TTNApeldoorn/esp32-p1-watermeter-node/hardware/documentation/LILYGO-G511-01_1_-1500x1500.jpg

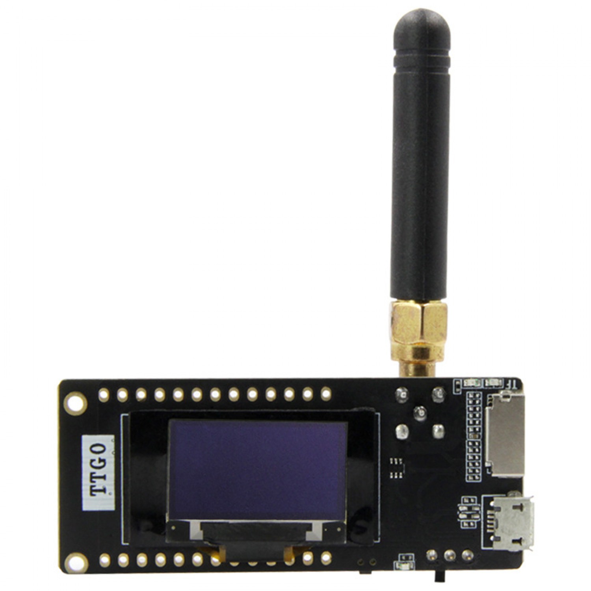
hardware/documentation/LILYGO-G511-01_1_-1500x1500.jpg
