TTNApeldoorn/esp32-p1-watermeter-node/hardware/documentation/LILYGO-G240-01_3_-1500x1500.jpg

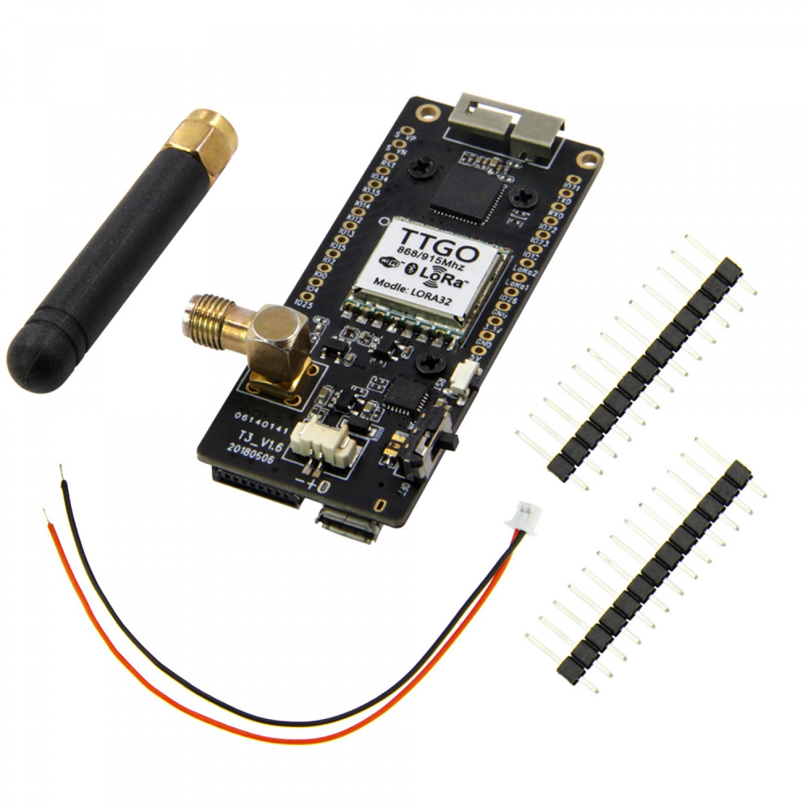
hardware/documentation/LILYGO-G240-01_3_-1500x1500.jpg
