TTNApeldoorn/esp32-p1-watermeter-node/hardware/documentation/bom.md

[Terminal Block voor Afneembare Schroefterminal - 90° - 3p - 3.81mm](
https://www.tinytronics.nl/nl/kabels-en-connectoren/connectoren/schroefterminals/terminal-block-voor-afneembare-schroefterminal-90-3p-3.81mm)
[Afneembare Schroefterminal - 3p - 3.81mm](https://www.tinytronics.nl/nl/kabels-en-connectoren/connectoren/schroefterminals/afneembare-schroefterminal-3p-3.81mm)

[LJ18A3-8-Z/BX - 5V Nabijheids sensor N/O NPN 8mm](https://opencircuit.nl/product/lj18a3-8-z-bx-5v-nabijheids-sensor-n-o-npn-8mm)
