TTNApeldoorn/esp32-p1-watermeter-node/hardware/documentation/2b7144094_lj18a3-8-z-bx-5v-nabijheids-sensor-n-o-npn-8mm_x.jpg

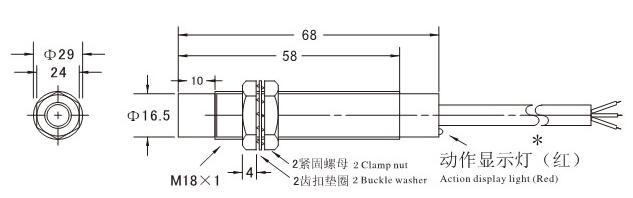
hardware/documentation/2b7144094_lj18a3-8-z-bx-5v-nabijheids-sensor-n-o-npn-8mm_x.jpg
