TTNApeldoorn/esp32-p1-watermeter-node/hardware/documentation/LILYGO-G240-01_4-1500x1500h.jpg

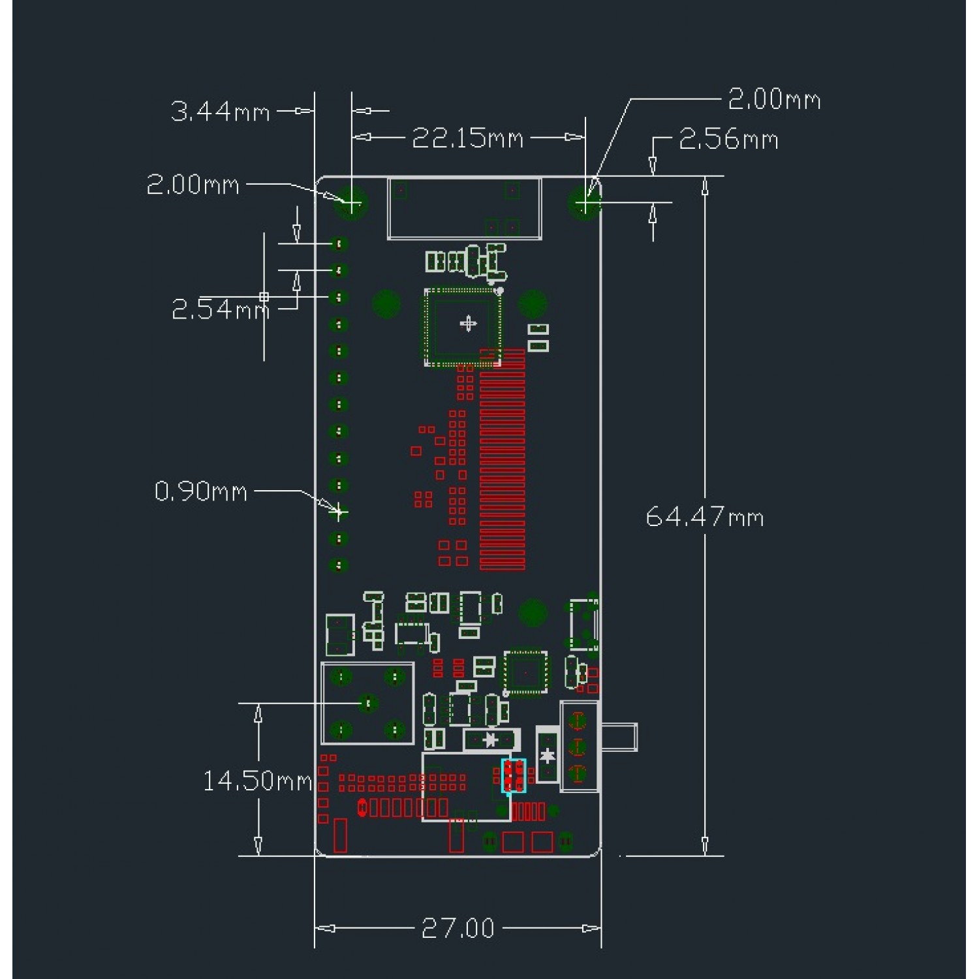
hardware/documentation/LILYGO-G240-01_4-1500x1500h.jpg
