TTNApeldoorn/esp32-p1-watermeter-node/hardware/documentation/removable-screw-terminal-3p-3.81mm-dimensions-600x600w.jpg

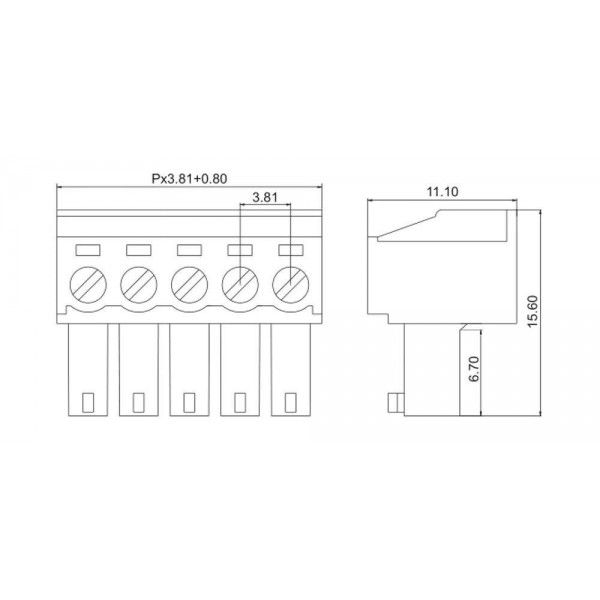
hardware/documentation/removable-screw-terminal-3p-3.81mm-dimensions-600x600w.jpg
