TTNApeldoorn/esp32-p1-watermeter-node/hardware/documentation/terminal-block-for-removable-screw-terminal-90-3p-3.81mm-dimensions-600x600w.jpg

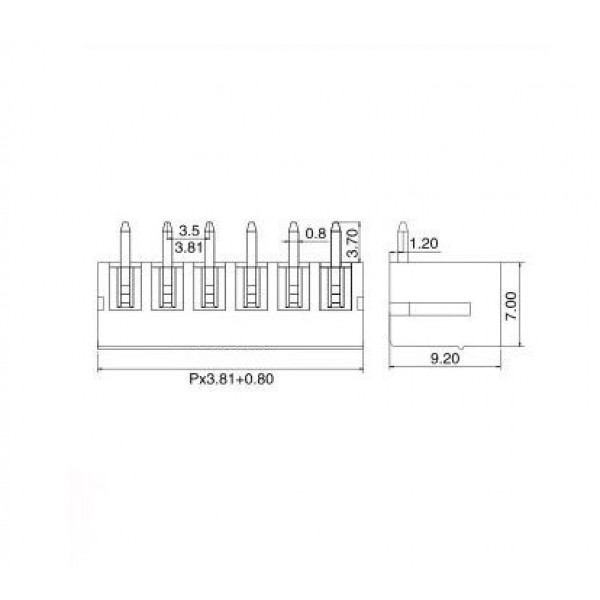
hardware/documentation/terminal-block-for-removable-screw-terminal-90-3p-3.81mm-dimensions-600x600w.jpg
