TTNApeldoorn/esp32-p1-watermeter-node/hardware/esp32-p1-water-node-board/esp32-p1-node-board/0_5_Back_esp32-p1-node-board.png

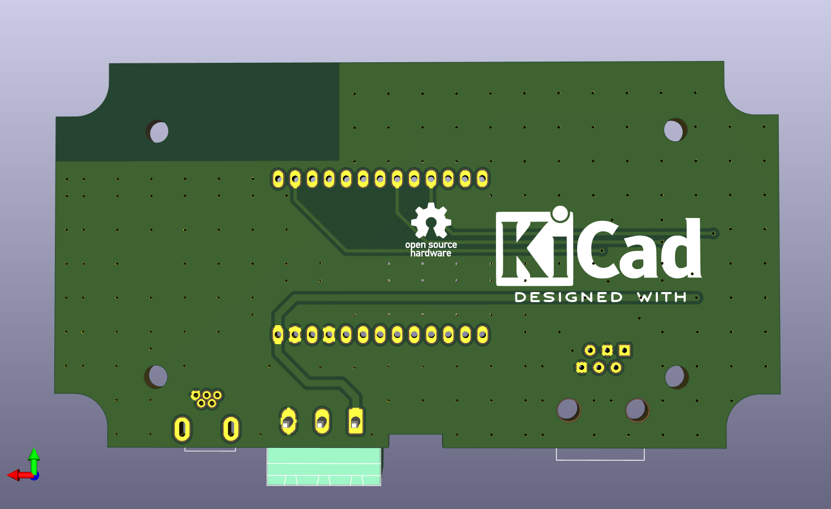
hardware/esp32-p1-water-node-board/esp32-p1-node-board/0_5_Back_esp32-p1-node-board.png
