TTNApeldoorn/esp32-p1-watermeter-node/hardware/esp32-p1-water-node-board/esp32-p1-node-board/esp32-p1-node-board.kicad_pcb

## KiCad design hardware/esp32-p1-water-node-board/esp32-p1-node-board/esp32-p1-node-board.kicad_pcb (2025-01-27)

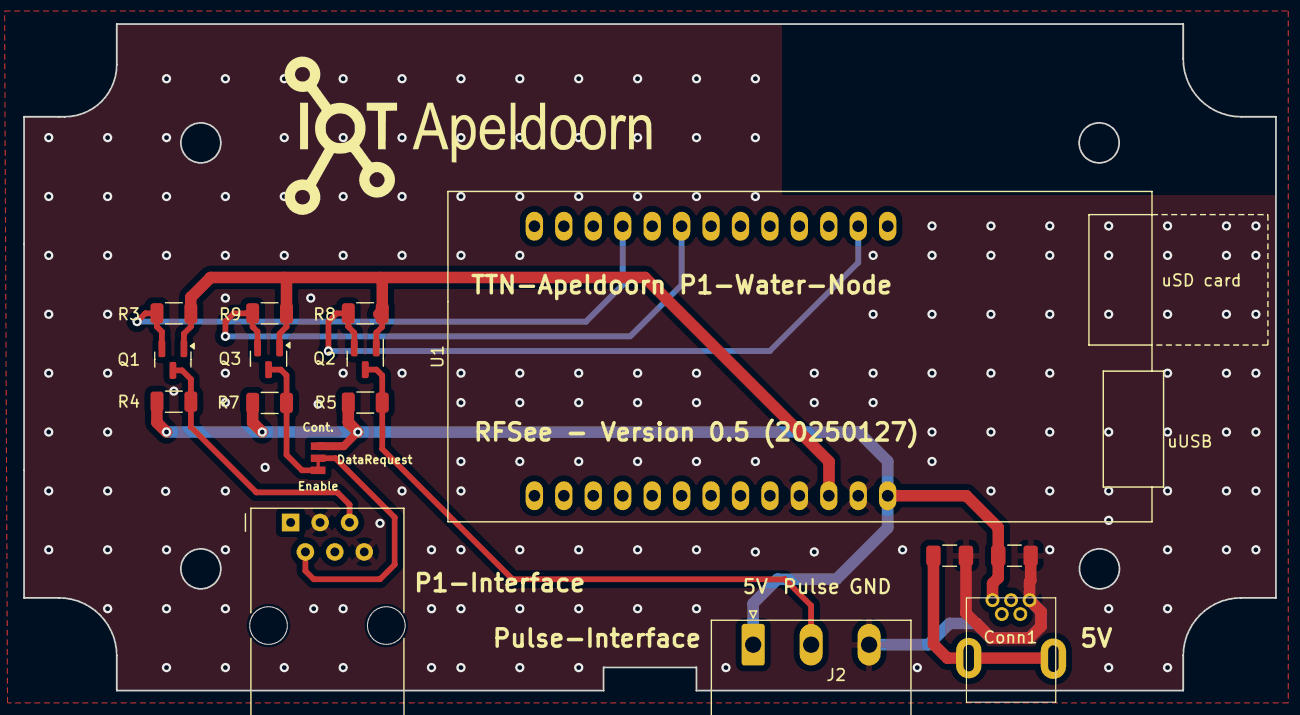
[picture p13: board esp32-p1-node-board.kicad_pcb from above]

Board: 2 copper layers, 108.0 x 57.5 mm, 16 parts (0 on the bottom side), 11 nets.

Parts:
C2, C3: 10n; C_1206_3216Metric
Conn1: THT_USB-B-Mini
J1: RJ11-6; RJ12_Amphenol_54601
J2: Conn_01x03; PhoenixContact_MSTBA_2,5_3-G_1x03_P5.00mm_Horizontal
JP1: Jumper_3_NC-1_Trace_NoSilk
Q1, Q2, Q3: BSS138; SOT-23
R3, R4, R5, R7, R8, R9: 10K; R_1206_3216Metric
U1: TTGO_T3_V1.6.1

Connections:
/3V3: Q1.1 (G), Q2.1 (G), Q3.1 (G), R3.1, R8.1, R9.1, U1.11 (3V3)
/5V: C2.1, Conn1.1 (VCC), J2.1, JP1.3, R4.1, R5.1, R7.1, U1.13 (5V)
/DATA_P1: J1.5, Q1.3 (D), R4.2
/DATA_P1_3V3: Q1.2 (S), R3.2, U1.23 (IO34)
/DATA_P1_GND: C2.2, C3.1, Conn1.5 (GND), J1.3, J1.6, J2.3, U1.10 (GND), U1.12 (GND)
/DATA_P1_REQ: J1.2, JP1.2 (C)
/DATA_P1_REQ_3V3: Q3.2 (S), R9.2, U1.21 (IO14)
/PULSE_WATER: J2.2, Q2.3 (D), R5.2
/PULSE_WATER_3V3: Q2.2 (S), R8.2, U1.15 (IO04)
unnamed: C3.2, Conn1.6 (Shield), Conn1.7 (Shield)
unnamed: JP1.1 (A), Q3.3 (D), R7.2
