TTNApeldoorn/esp32-p1-watermeter-node/software/src/main.cpp

/*--------------------------------------------------------------------
  De Slimme Meter DSM
  Reads the Dutch Smart Meter and send data to LoRa network

  Author Marcel Meek
  Date 12/7/2020
  changed 16-5-2021
  - MCCI Catena lora stack
  - worker loop changed
  - deveui from chipid
  - dsm parser updated 
  - detect auto baudrate 115K2 or 9600
  - sw serial removed
  --------------------------------------------------------------------*/
#include <Arduino.h>

//Libraries for OLED Display
#include <Wire.h>
#include <Adafruit_GFX.h>
#include <Adafruit_SSD1306.h>
#include <Preferences.h>
#include "config.h"
#include "lora.h"
#include "dsm.h"

//OLED pins
#define OLED_SDA 21  //4
#define OLED_SCL 22  //15
//#define OLED_RST 16   // !!!! helaas ook RX UART 2 en daarom niet bruikbaar voor P1 port :-(
#define SCREEN_WIDTH 128 // OLED display width, in pixels
#define SCREEN_HEIGHT 64 // OLED display height, in pixels

// pin definition
#define WATER_PIN 4
#define RTS_PIN 14 // Serial 2
#define RX_PIN 34  // Serial 2
#define TX_PIN 35  // Serial 2

// forward declarations
void loraWorker( );


Preferences preferences;
Adafruit_SSD1306 display(SCREEN_WIDTH, SCREEN_HEIGHT, &Wire);  //, OLED_RST);
Dsm dsm( Serial2);                   // DSM on HW Serial port 2

int baudrate = 115200;
long cycleTime = CYCLETIME;
bool ttnOk = false;
bool dsmOk = false;
char deveui[32];
unsigned long count = 0;
unsigned long debounce = 0;

// watermeter intterupt
void IRAM_ATTR isr() {

  if( millis() - debounce > 300 ) {
    if( digitalRead( WATER_PIN) == 0) {
      count++;
    }
  }
  //Serial.println( count );
  debounce = millis();
}


// LoRa receive handler (downnlink)
void loracallback( unsigned int port, unsigned char* msg, unsigned int len) {
  printf("lora download message received port=%d len=%d\n", port, len);

  // change cycle time in seconds with a remote TTN downlink command
  // port is 40, byte 0 is low byte 1 is high byte
  if ( port == 40 && len >= 2) {
    int value = msg[0] + 256 * msg[1];
    if ( value >= 20 && value <= 3600) {
      cycleTime = value;
      printf( "cycleTime changed to %d sec.\n" , value);
    }
  }
}

void changeBaudrate() {
  Serial2.end();
  delay(1000);
  baudrate = ( baudrate == 9600) ? 115200 : 9600;
  Serial2.begin( baudrate, SERIAL_8N1, RX_PIN, TX_PIN, true); // rx, tx, true is invert data
  delay(200);
  printf("baudrate changed to %d\n", baudrate);
}


void setup() {
  // auto baudrate, start with 115200
  baudrate = 115200;

// dsm pin RTS
  pinMode( RTS_PIN, OUTPUT);
  digitalWrite( RTS_PIN, LOW);   // disable dsm

    // LoRa send LED
  pinMode(LED_BUILTIN, OUTPUT);
  digitalWrite( LED_BUILTIN, LOW);   // off
  //printf("LED_BUILTIN %d\n", LED_BUILTIN);

  Serial.begin( 115200);
  Serial2.begin( baudrate, SERIAL_8N1, RX_PIN, TX_PIN, true);  //  rx, tx, true is invert data
  delay(200);

  // get chip id, to be used for DEVEUI LoRa
  uint64_t chipid = ESP.getEfuseMac();   //The chip ID is essentially its MAC address(length: 6 bytes).
  sprintf(deveui, "%08X%08X", (uint16_t)(chipid >> 32), (uint32_t)chipid);
  printf("deveui=%s\n", deveui);

  //initialize OLED
  Wire.begin(OLED_SDA, OLED_SCL);
  if (!display.begin(SSD1306_SWITCHCAPVCC, 0x3c, false, false)) { // Address 0x3C for 128x32
    printf("SSD1306 allocation failed\n");
    for (;;); // Don't proceed, loop forever
  }

// get watercounter form resident memory
  preferences.begin("water", false);
  count = preferences.getULong("counter"); 
  printf("setup: counter=%lu\n", count);
  
  display.clearDisplay();
  //display.setRotation( 2);  // rotate 180 degrees
  display.setTextColor(WHITE);
  display.setTextSize(1);
  display.setCursor(0, 11);  display.printf("TTN Slimme meter %s", VERSION);
  display.setCursor(0, 22);  display.printf("Id %s", deveui + 4);
  display.setCursor(0, 33);  display.printf("Starting up ...");
  display.display();

   printf("baudrate=%d\n", baudrate);

// set interrupt for watermeter
  pinMode( WATER_PIN, INPUT);
  attachInterrupt( WATER_PIN, isr, FALLING);

//initialize LoRa
  loraBegin( APPEUI, deveui, APPKEY);
  loraSetRxHandler( loracallback);    // set LoRa receive handler (downnlink)
  loraSetWorker( loraWorker);         // set Worker handler
  loraSleep(1);                      // start worker 

  printf("Initializing OK!\n");
}

void displayOLED() {
  display.clearDisplay();
  //display.setRotation( 2);  // rotate 180 degrees
  display.setCursor(0, 0);  display.printf( " Laag");
  display.setCursor(64, 0); display.printf( " Hoog");
  display.setCursor(0, 11); display.printf( " %.3f", dsm.laag);
  display.setCursor(64, 11); display.printf( " %.3f", dsm.hoog);
  display.setCursor(0, 22); display.printf( "-%.3f", dsm.laagTerug);
  display.setCursor(64, 22); display.printf( "-%.3f", dsm.hoogTerug);
  display.setCursor(0, 33); display.printf( " Gas %.3f", dsm.gas);
  display.setCursor(0, 44); display.printf( " Water %.3f", count/1000.0);
  //display.setCursor(0, 44); display.printf( " Id %X %s", dsm.id, deveui + 4);
  //display.setCursor(0, 44); display.printf( " Id %s", deveui + 4);
  display.setCursor(0, 55); 
  if(dsmOk) 
    display.printf( " DSM %d", baudrate);
  else 
    display.printf( " DSM fail");
  display.setCursor(64, 55); display.printf( " TTN %s", (ttnOk) ? "ok" : "fail");
  display.display();
}

void sendToTTN( ) {
  struct {
    uint32_t id;
    float laag, hoog, laagterug, hoogterug, gas, water;
  } payload;

  payload.id = dsm.id;
  payload.laag = dsm.laag;
  payload.hoog = dsm.hoog;
  payload.laagterug = dsm.laagTerug;
  payload.hoogterug = dsm.hoogTerug;
  payload.gas = dsm.gas;
  payload.water = count /1000.0;

  printf("send TTN len=%d\n", sizeof( payload));
  loraSend( 40, (unsigned char*)&payload, sizeof( payload));  // use port 40
}

void loraWorker( ) {
  printf("Worker\n");

  digitalWrite( RTS_PIN, HIGH);   // enable dsm
  dsmOk = dsm.read();
  if( dsmOk == false) {     // read error, try another baudrate
    changeBaudrate();
    dsmOk = dsm.read();
  }
  digitalWrite( RTS_PIN, LOW);   // disable dsm

  //dsm.debug();
  //printf("end read DSM, baudrate=%d, dsmOk=%d\n", baudrate, dsmOk);

  digitalWrite( LED_BUILTIN, HIGH);
  if( !loraConnected()) {
    printf("loraJoin\n");
    loraJoin();
    while ( !loraTxReady() )
      loraLoop(); 
  }

  if( loraConnected()) {
    printf("sendToTTN\n");
    sendToTTN();
    while ( !loraTxReady() )
      loraLoop(); 
  }
  digitalWrite( LED_BUILTIN, LOW);

  ttnOk = loraConnected();
  displayOLED();   // display it

  // if changed, update watercounter
  if( preferences.getULong("counter") != count ); 
    preferences.putULong("counter", count); 
  printf("worker: counter=%lu\n", count);
  loraSleep( (ttnOk) ? cycleTime : 15);
}

void loop() {
   loraLoop();
}
