TTNApeldoorn/esp32-p1-watermeter-node/(commit log)

2024-10-23 Added kicad library pe1mew
2024-10-24 Corrections on circuit
    [esp32-p1-node-board.kicad_sch]
2024-10-30 Add docs and BOM
2024-10-31 Updated files to KiCad 8.0
    [esp32-p1-node-board.kicad_pcb, esp32-p1-node-board.kicad_sch]
2024-11-17 Start design PCB
    [esp32-p1-node-board.kicad_pcb, esp32-p1-node-board.kicad_sch]
2024-11-18 Final PCB design voor proef
    [esp32-p1-node-board.kicad_pcb, esp32-p1-node-board.kicad_sch]
2024-11-21 platformio source files
    prototype version
2025-01-27 Updated PCB to version 0.5
    [esp32-p1-node-board.kicad_pcb, esp32-p1-node-board.kicad_sch]
